scattercat-123/KeeBoard/README.md

# KeeBoard ⌨️ 🔥
<b>Check out my journal of mkaing this in the JOURNAL.md File!</b>
## A DIY ReallY cool mecahnical wired keyboard with backlighting which doesnt use an mcu! (Uses an atmeg32u4 chip inside, NEEDED TO MAKE MY OWN MCU INSIDE MY PCB).


## 🔥 Whats cool in this keyboard:
 - Almost Fully cnc'd aluminium anodized parts for smooth good finish.
 - A fully TPU Gasket mounted keyboard!
 - A 65% keyboard which does have the function keys, numpad but still has the arrow keys!
 - Full neopixels RGB backlighting for extra aesthetics 🌈.
 - Fully custom design, no mcu which saves place in the keyboard. it uses and embedded chip and crystal and stuff inside the PCB (USING QMK firmware).
 - Compact and ergonomic. Has a 5 degree tilt for better posture for wrists. Only about 3cm thick on the higher angeled side.
 - USB-C on the side for less wiring.
 - Has a rotatory encoder in it for volume/brightness control.
 - Ig cheap for a premium custom cnc'd keyboard.

## BOM:
|No.|Part Name |Quantity Required |Price in $|Price in ₹|Buying Link |FIELD7|
|---|---|---|---|---|---|---|
|1  |PCB from JLCPCB |5 (MOQ) |$16.57 |₹1,452.00 | | |
|2  |Keycaps set (blaze color) |1 |$14.82 |₹1,299.00 |https://stackskb.com/store/veekos-gradient-keycaps-cherry-profile-135-keys/ | |
|3  |Stabilizers set |1 |$18.20 |₹1,595.00 |https://stackskb.com/store/durock-smokey-screw-in-stabilizers-v2/ | |
|4  |USB-C coiled cable |1 |$19.38 |₹1,699.00 |https://keychron.in/product/coiled-type-c-cable/ | |
| |CNC Machined JLC CNC |3 different parts |$50.00 |₹9,000.00 |approx price | |
|6  |Gaetron Switch opener |1 |$21.09 |₹1,849.00 |https://keychron.in/product/gateron-switch-opener/ | |
|7  |Key Switches Gaetron Milky Yellow |1 |$38.71 |₹3,393.00 |https://www.desertcart.in/products/639473967 | |
|8  |Keycap Puller |1 |$3.76 |₹330.00 |https://www.amazon.in/MAXBELL-Portable-Remover-Mechanical-Keyboard/dp/B09GPNC5FN#averageCustomerReviewsAnchor | |
|9  |LCSC Electronics(capacitors, resistors, chips etc|19 different components|$53.93 |₹4,727.00 | | |
|10 |Screws |Many |$2.28 |₹200.00 |https://onlyscrews.in/ | |
|11 |Foam for gaskets |1 |$3.42 |₹300.00 |https://www.amazon.in/Lakeer-Scrapbooking-Projects-Decorations-Multicolour/dp/B07QP8GC9Z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| |
|12 | | | | | | |
|13 | | | | | | |
|14 | | | | | | |
|15 | | | | | | |
| |Total |Price of ALL: |$242.17 |₹25,844.00| | |
## Few snapshots!:
