scattercat-123/KeeBoard/pcb-files gerbers & kicad/PCB.md

I have used JLCPCB for the pcb process.
Feel free to use my design if needed
