scattercat-123/KeeBoard/pcb-files gerbers & kicad/kicad/KeeBoard.kicad_sch

## KiCad design pcb-files gerbers & kicad/kicad/KeeBoard.kicad_sch (2025-08-13)

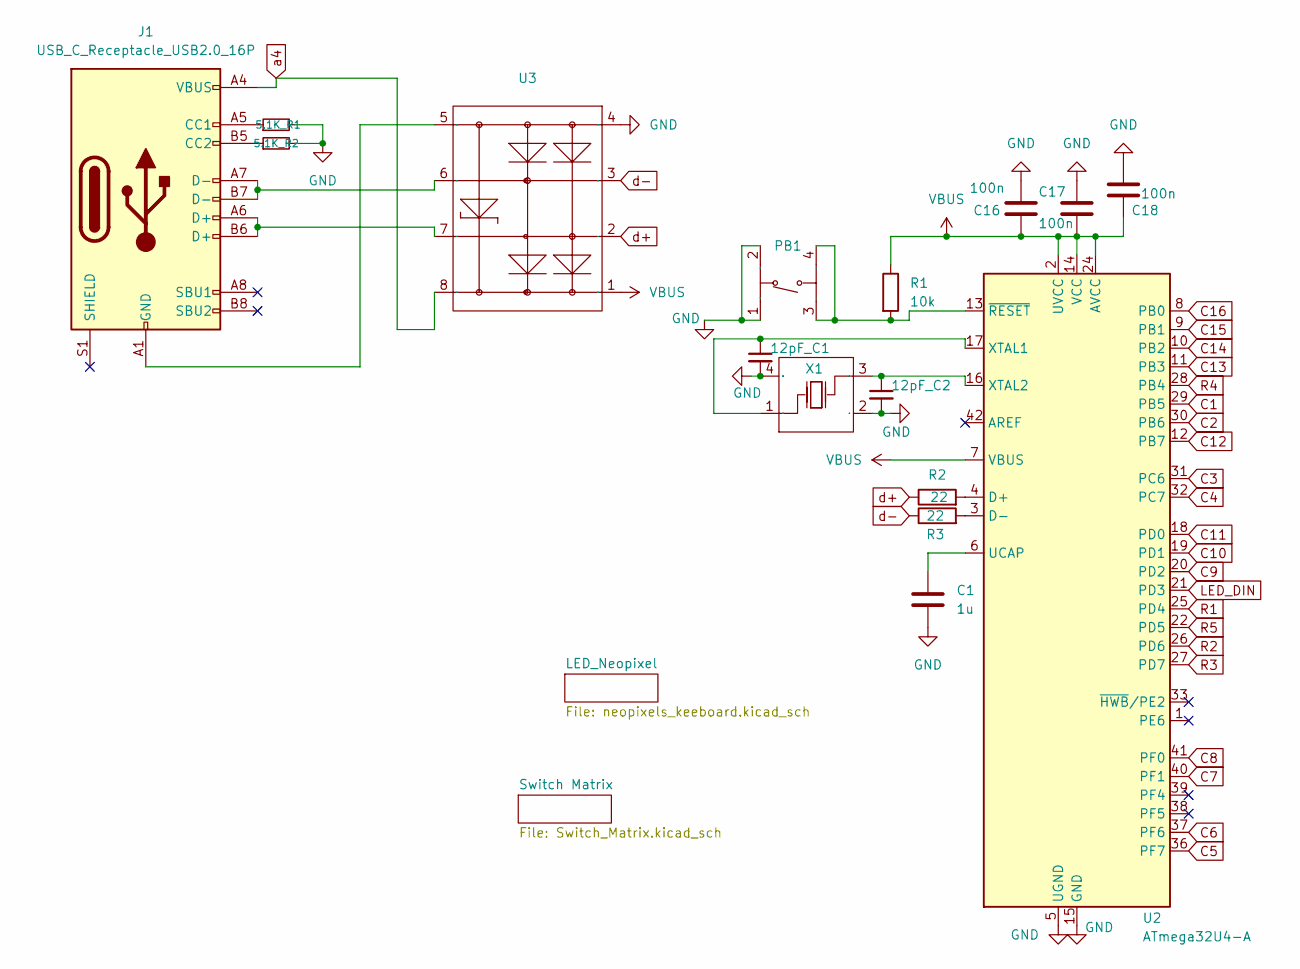
[picture p1: schematic KeeBoard.kicad_sch]

Parts:
5.1K_R1, 5.1K_R2: R_Small; R_1206_3216Metric
12pF_C1, 12pF_C2: C_Small; C_1206_3216Metric
C1: 1u; C_1206_3216Metric
C16, C17, C18: 100n; C_1206_3216Metric
J1: USB_C_Receptacle_USB2.0_16P; USB-C_SMD-TYPE-C-31-M-12 HRO
PB1: SW-SMD_4P-L5.1-W5.1-P3.70-LS6.5-TL_H1.5 C318884 push button
R1: 10k; R_1206_3216Metric
R2, R3: 22; R_1206_3216Metric
U2: ATmega32U4-A; Microchip Tech ATMEGA32U4RC-AU
U3: SOIC-8_L4.9-W3.9-P1.27-LS6.0-BL usb6b1rl; Manufacturer Part USB6B1RL
X1: 16MHz; CRYSTAL-SMD_4P-L3.2-W2.5-BL 16mHZ

Connections:
C1: U2.29 (PB5)
C2: U2.30 (PB6)
C3: U2.31 (PC6)
C4: U2.32 (PC7)
C5: U2.36 (PF7)
C6: U2.37 (PF6)
C7: U2.40 (PF1)
C8: U2.41 (PF0)
C9: U2.20 (PD2)
C10: U2.19 (PD1)
C11: U2.18 (PD0)
C12: U2.12 (PB7)
C13: U2.11 (PB3)
C14: U2.10 (PB2)
C15: U2.9 (PB1)
C16: U2.8 (PB0)
GND: 5.1K_R1.2, 5.1K_R2.2, 12pF_C1.2, 12pF_C2.2, C1.2, C16.1, C17.1, C18.1, PB1.1 (A), PB1.2 (B), U2.5 (UGND), U2.15 (GND), U2.23 (GND), U2.35 (GND), U2.43 (GND), U3.4 (GND), X1.2 (GND), X1.4 (GND)
LED_DIN: U2.21 (PD3)
unnamed: 5.1K_R1.1, J1.B5 (CC2)
unnamed: 5.1K_R2.1, J1.A5 (CC1)
unnamed: 12pF_C1.1, U2.17 (XTAL1), X1.1 (OSC1)
unnamed: 12pF_C2.1, U2.16 (XTAL2), X1.3 (OSC2)
unnamed: C1.1, U2.6 (UCAP)
unnamed: J1.A1 (GND), J1.A12 (GND), J1.B1 (GND), J1.B12 (GND), U3.5 (GND)
unnamed: J1.A6 (D+), J1.B6 (D+), U3.7 (I/O1)
unnamed: J1.A7 (D-), J1.B7 (D-), U3.6 (I/O2)
unnamed: PB1.3 (C), PB1.4 (D), R1.2, U2.13 (~RESET)
unnamed: R2.2, U2.4 (D+)
unnamed: R3.2, U2.3 (D-)
R1: U2.25 (PD4)
R2: U2.26 (PD6)
R3: U2.27 (PD7)
R4: U2.28 (PB4)
R5: U2.22 (PD5)
VBUS: C16.2, C17.2, C18.2, R1.1, U2.2 (UVCC), U2.7 (VBUS), U2.14 (VCC), U2.24 (AVCC), U2.34 (VCC), U2.44 (AVCC), U3.1 (VCC)
a4: J1.A4 (VBUS), J1.A9 (VBUS), J1.B4 (VBUS), J1.B9 (VBUS), U3.8 (VCC)
d+: R2.1, U3.2 (I/O1)
d-: R3.1, U3.3 (I/O2)
