scattercat-123/KeeBoard/JOURNAL.md

<!--
  ===================    !!READ THIS NOTICE!!   ====================
  DO NOT edit this file manually. Your changes WILL BE OVERWRITTEN!
  This journal is auto generated and updated by Hack Club Blueprint.
  To edit this file, please edit your journal entries on Blueprint.
  ==================================================================
-->

This is my journal of the design and building process of **Updated PCB for my Keyboard project which hasn't been finished and had failed.**.  
You can view this journal in more detail on **Hack Club Blueprint** [here](https://blueprint.hackclub.com/projects/142).

## 10/4/2025 - I made a new journal, i edited the schematic..  

You can check my previous journal over [here](https://github.com/scattercat-123/KeeBoard/blob/main/PREVIOUS_JOURNAL.md).
This journal is to finish my keyboard projejct called Keeboard. My PCB wasnt perfect and it was bad. so making a new design. I have the cad ready, just gonna make a new pcb or update the cad also!


I just updated some of the schematic...
