scattercat-123/KeeBoard/(commit log)

2025-07-04 added PCB.md for no reason ig
2025-07-04 Added all the pcb production files. bruh y is this so slow
    [KeeBoard-B_Cu.gbr, KeeBoard-B_Mask.gbr, KeeBoard-B_Paste.gbr, KeeBoard-B_Silkscreen.gbr, KeeBoard-Edge_Cuts.gbr, KeeBoard-F_Cu.gbr, KeeBoard-F_Mask.gbr, KeeBoard-F_Paste.gbr]
2025-07-04 Create a kicad.md for no reason again.
2025-07-04 Added all the kicad files! Take a look at them if you want💀
    [KeeBoard.kicad_sch, Switch_Matrix.kicad_sch, neopixels_keeboard.kicad_sch]
2025-07-09 Added bom to repo bruh
    [KeeBoard BOM.csv]
2025-08-13 cleaned up messy repo
    [KeeBoard-B_Cu.gbr, KeeBoard-B_Mask.gbr, KeeBoard-B_Paste.gbr, KeeBoard-B_Silkscreen.gbr, KeeBoard-Edge_Cuts.gbr, KeeBoard-F_Cu.gbr, KeeBoard-F_Mask.gbr, KeeBoard-F_Paste.gbr]
2025-08-15 updated readme bom
2025-08-15 updated bom
    [KeeBoard BOM.csv]
2025-08-15 updated bom (price optimize)
2025-09-08 Update KeeBoard BOM.csv
    [KeeBoard BOM.csv]
